TrevorKayongaJoel/PCB-Firmware-for-AWS/NEW PCB FILES/AWS POWER/AWS POWER/AWS POWER.kicad_pcb

## KiCad design NEW PCB FILES/AWS POWER/AWS POWER/AWS POWER.kicad_pcb (2026-09-30)

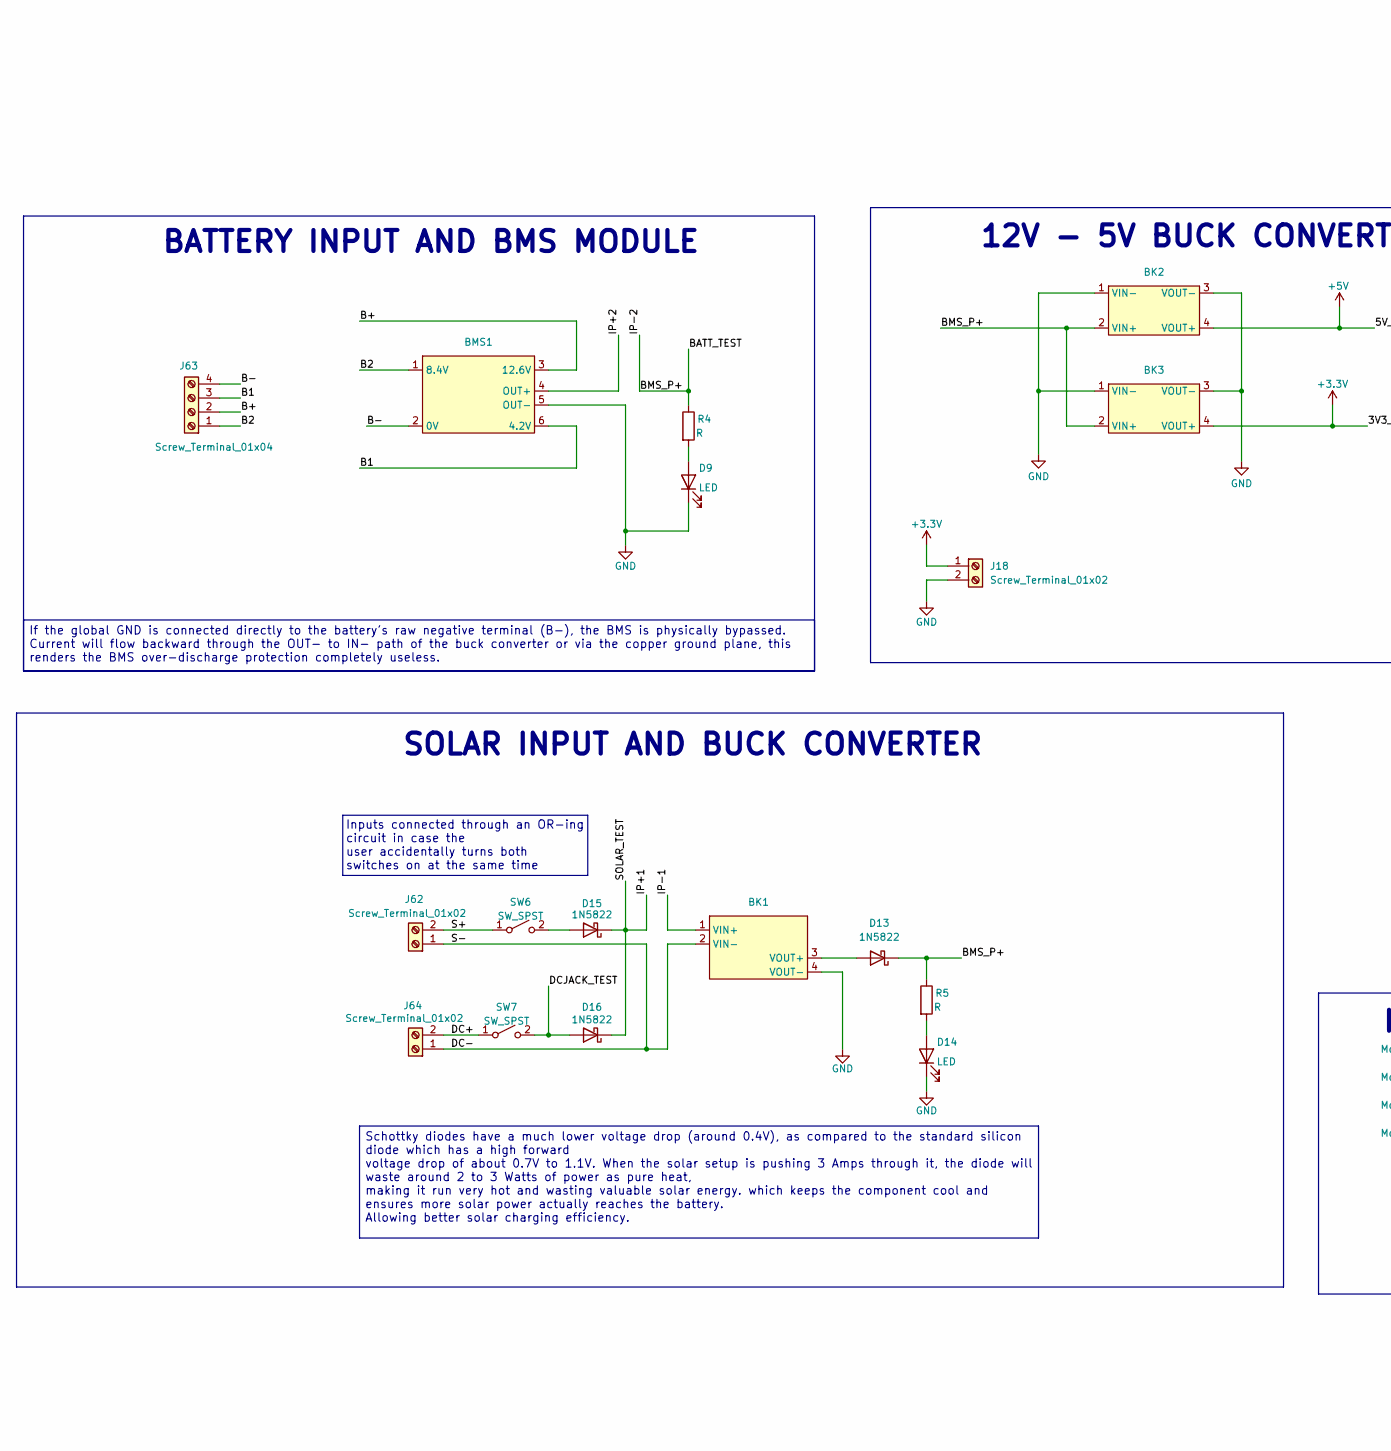
[picture p1: schematic AWS POWER.kicad_sch, part in row 1, column 1]

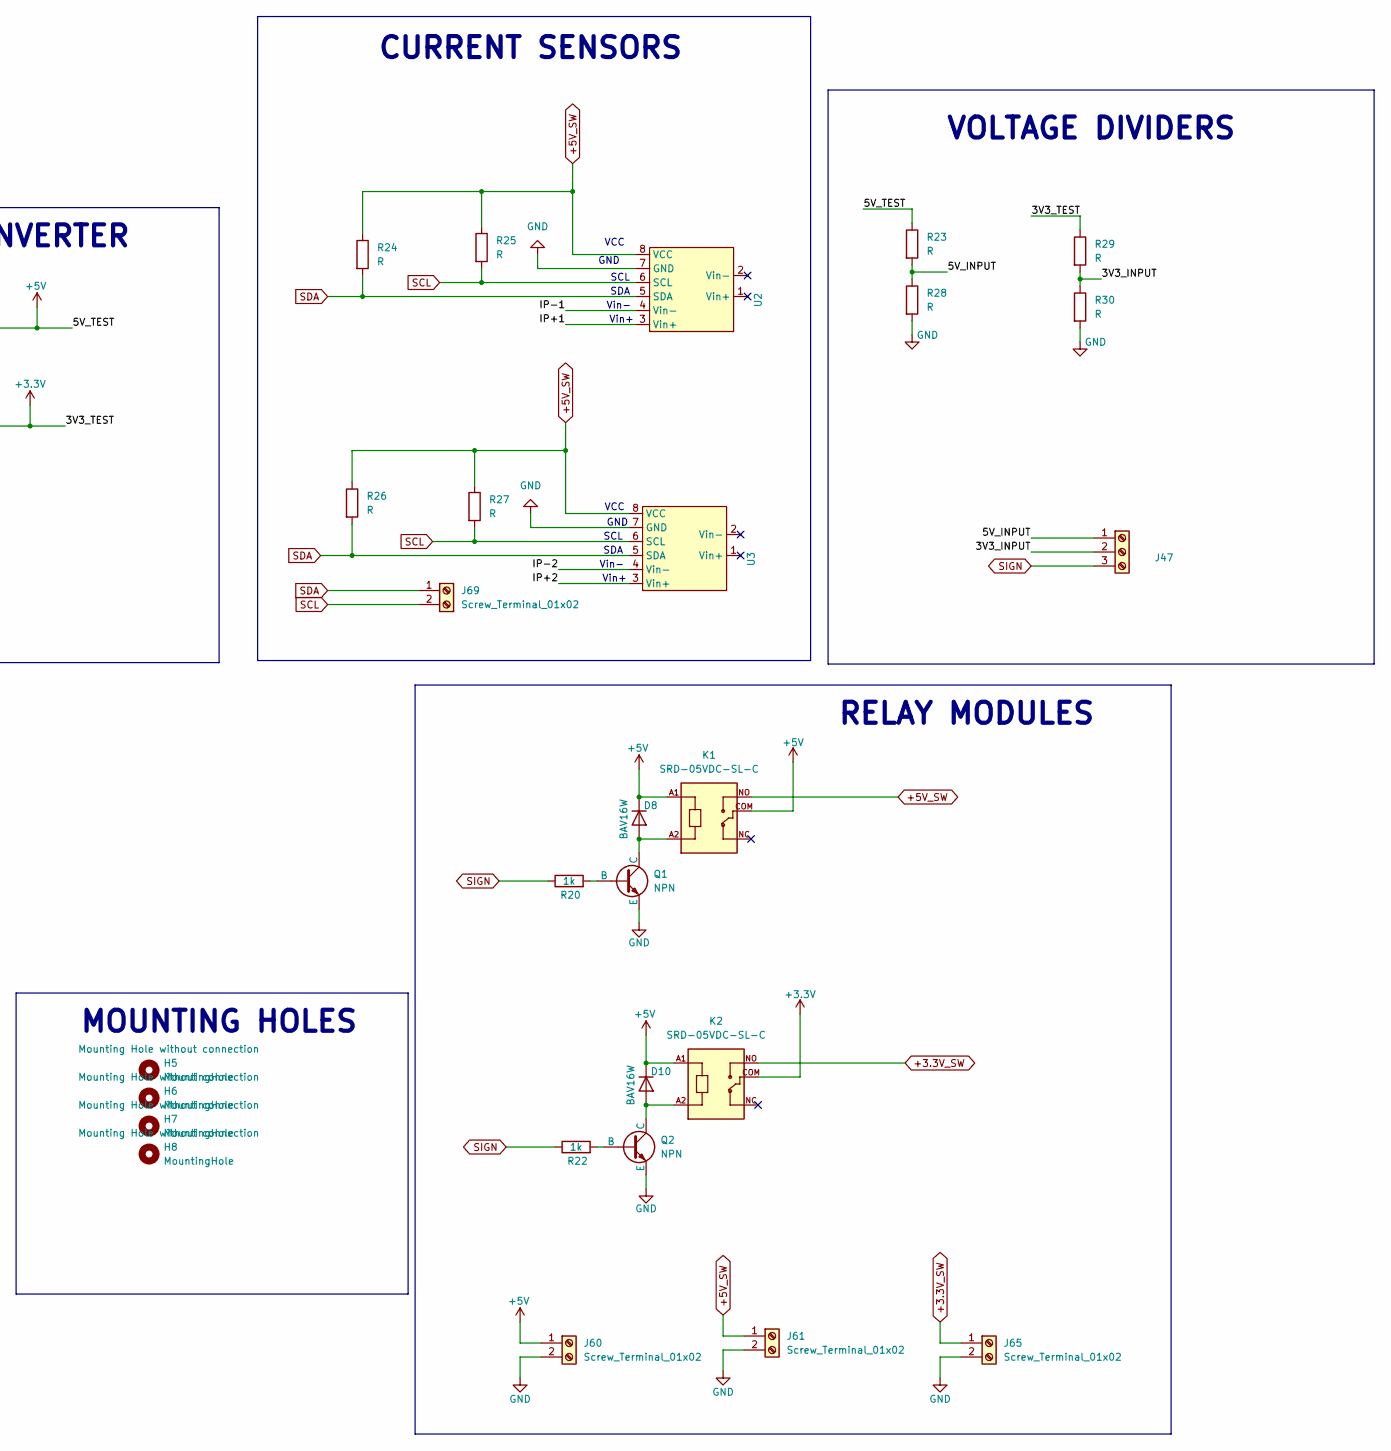
[picture p2: schematic AWS POWER.kicad_sch, part in row 1, column 2]

Parts:
BK1: cn4015-2_module
BK2, BK3: MP1584 MODULE
BMS1: 3S 40A BMS
D8, D10: BAV16W; D_DO-201AD_P15.24mm_Horizontal; LCSC C459527
D9, D14: LED; LED_D3.0mm
D13, D15, D16: 1N5822; D_DO-201AD_P15.24mm_Horizontal
H5, H6, H7, H8: MountingHole; MountingHole_3.2mm_M3_DIN965_Pad_TopOnly
J18, J60, J61, J62, J64, J65, J69: Screw_Terminal_01x02; TerminalBlock_MetzConnect_Type055_RT01502HDWU_1x02_P5.00mm_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
J47: Screw_Terminal_01x03; TerminalBlock_MaiXu_MX126-5.0-03P_1x03_P5.00mm
J63: Screw_Terminal_01x04; TerminalBlock_MetzConnect_Type055_RT01504HDWU_1x04_P5.00mm_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
K1, K2: SRD-05VDC-SL-C; RELAY_SRD-05VDC-SL-C; LCSC C35449
Q1, Q2: NPN; TO-92; LCSC C52801
R4, R5, R23, R24, R25, R26, R27, R28, R29, R30: R; R_Axial_DIN0207_L6.3mm_D2.5mm_P7.62mm_Horizontal
R20, R22: 1k; R_Axial_DIN0207_L6.3mm_D2.5mm_P7.62mm_Horizontal; LCSC C22548
SW6, SW7: SW_SPST; SW_DIP_SPSTx01_Slide_9.78x4.72mm_W7.62mm_P2.54mm
U2, U3: INA219 MODULE

Connections:
+3.3V: BK3.4 (VOUT+), J18.1, K2.COM, R29.1
+3.3V_SW: J65.1, K2.NO
+5V: BK2.4 (VOUT+), D8.1 (K), D10.1 (K), J60.1, K1.A1, K1.COM, K2.A1, R23.1
+5V_SW: J61.1, K1.NO, R24.1, R25.1, R26.1, R27.1, U2.8 (VCC), U3.8 (VCC)
/3V3_INPUT: J47.2, R29.2, R30.1
/5V_INPUT: J47.1, R23.2, R28.1
/B1: BMS1.6 (4.2V), J63.3
/B2: BMS1.1 (8.4V), J63.1
/B+: BMS1.3 (12.6V), J63.2
/B-: BMS1.2 (0V), J63.4
/BATT_TEST: BK2.2 (VIN+), BK3.2 (VIN+), D13.1 (K), R4.1, R5.1, U3.4 (Vin-)
/DC+: J64.2, SW7.1 (A)
/DC-: BK1.2 (VIN-), J62.1, J64.1
/DCJACK_TEST: D16.2 (A), SW7.2 (B)
/IP+1: D15.1 (K), D16.1 (K), U2.3 (Vin+)
/IP+2: BMS1.4 (OUT+), U3.3 (Vin+)
/IP-1: BK1.1 (VIN+), U2.4 (Vin-)
/S+: J62.2, SW6.1 (A)
GND: BK1.4 (VOUT-), BK2.1 (VIN-), BK2.3 (VOUT-), BK3.1 (VIN-), BK3.3 (VOUT-), BMS1.5 (OUT-), D9.1 (K), D14.1 (K), J18.2, J60.2, J61.2, J65.2, Q1.3 (E), Q2.3 (E), R28.2, R30.2, U2.7 (GND), U3.7 (GND)
unnamed: BK1.3 (VOUT+), D13.2 (A)
unnamed: D8.2 (A), K1.A2, Q1.1 (C)
unnamed: D9.2 (A), R4.2
unnamed: D10.2 (A), K2.A2, Q2.1 (C)
unnamed: D14.2 (A), R5.2
unnamed: D15.2 (A), SW6.2 (B)
unnamed: Q1.2 (B), R20.2
unnamed: Q2.2 (B), R22.2
SCL: J69.2, R25.2, R27.2, U2.6 (SCL), U3.6 (SCL)
SDA: J69.1, R24.2, R26.2, U2.5 (SDA), U3.5 (SDA)
SIGN: J47.3, R20.1, R22.1

Notes on the sheet:
SCL
CURRENT SENSORS
Inputs connected through an OR-ing circuit in case the user accidentally turns both switches on at the same time
MOUNTING HOLES
BATTERY INPUT AND BMS MODULE
VOLTAGE DIVIDERS
GND
SOLAR INPUT AND BUCK CONVERTER
SDA
VCC
Vin-
Vin+
RELAY MODULES
12V - 5V BUCK CONVERTER
Schottky diodes have a much lower voltage drop (around 0.4V), as compared to the standard silicon diode which has a high forward voltage drop of about 0.7V to 1.1V. When the solar setup is pushing 3 Amps through it, the diode will waste around 2 to 3 Watts of power as pure heat, making it run very 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
If the global GND is connected directly to the battery's raw negative terminal (B-), the BMS is physically bypassed. Current will flow backward through the OUT- to IN- path of the buck converter or via the copper ground plane, this renders the BMS over-discharge protection completely useless.

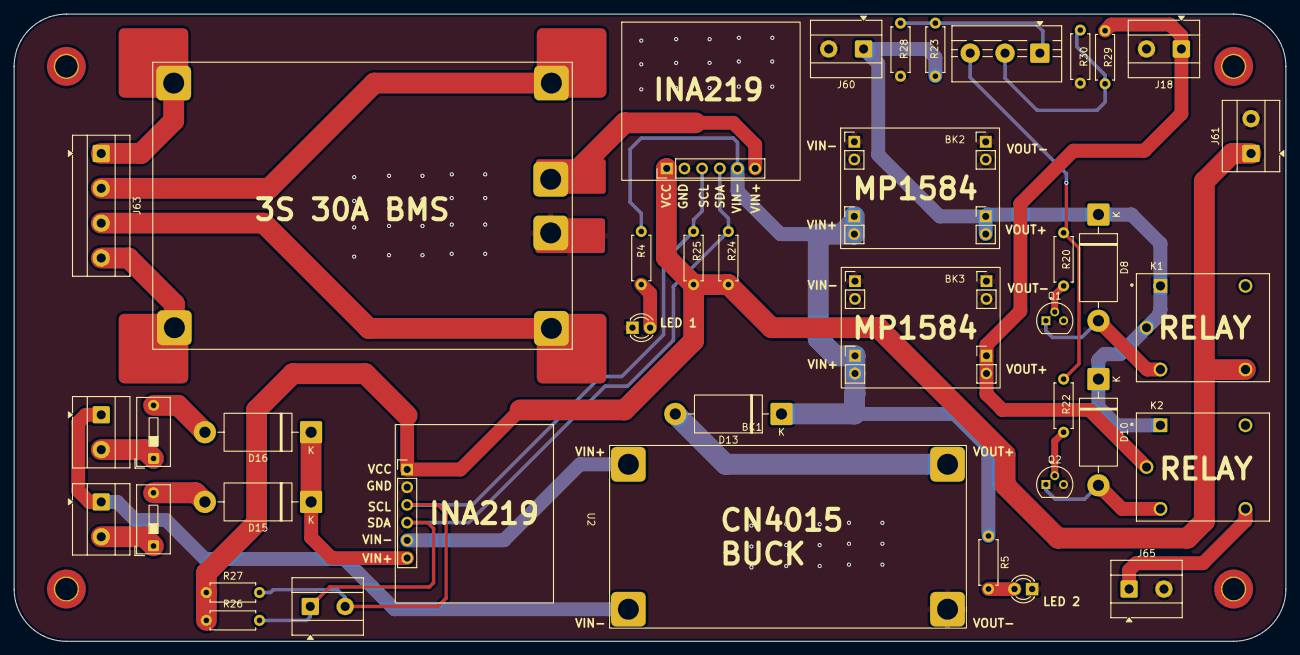
[picture p3: board AWS POWER.kicad_pcb from above]

Board: 2 copper layers, 182.5 x 90.0 mm, 44 parts (0 on the bottom side), 30 nets.

Other parts of the board:
H8#2: MountingHole; MountingHole_3.2mm_M3_DIN965_Pad_TopOnly
