TrevorKayongaJoel/PCB-Firmware-for-AWS/NEW PCB FILES/AWS GATEWAY/AWS GATEWAY.kicad_pcb

## KiCad design NEW PCB FILES/AWS GATEWAY/AWS GATEWAY.kicad_pcb (2026-09-30)

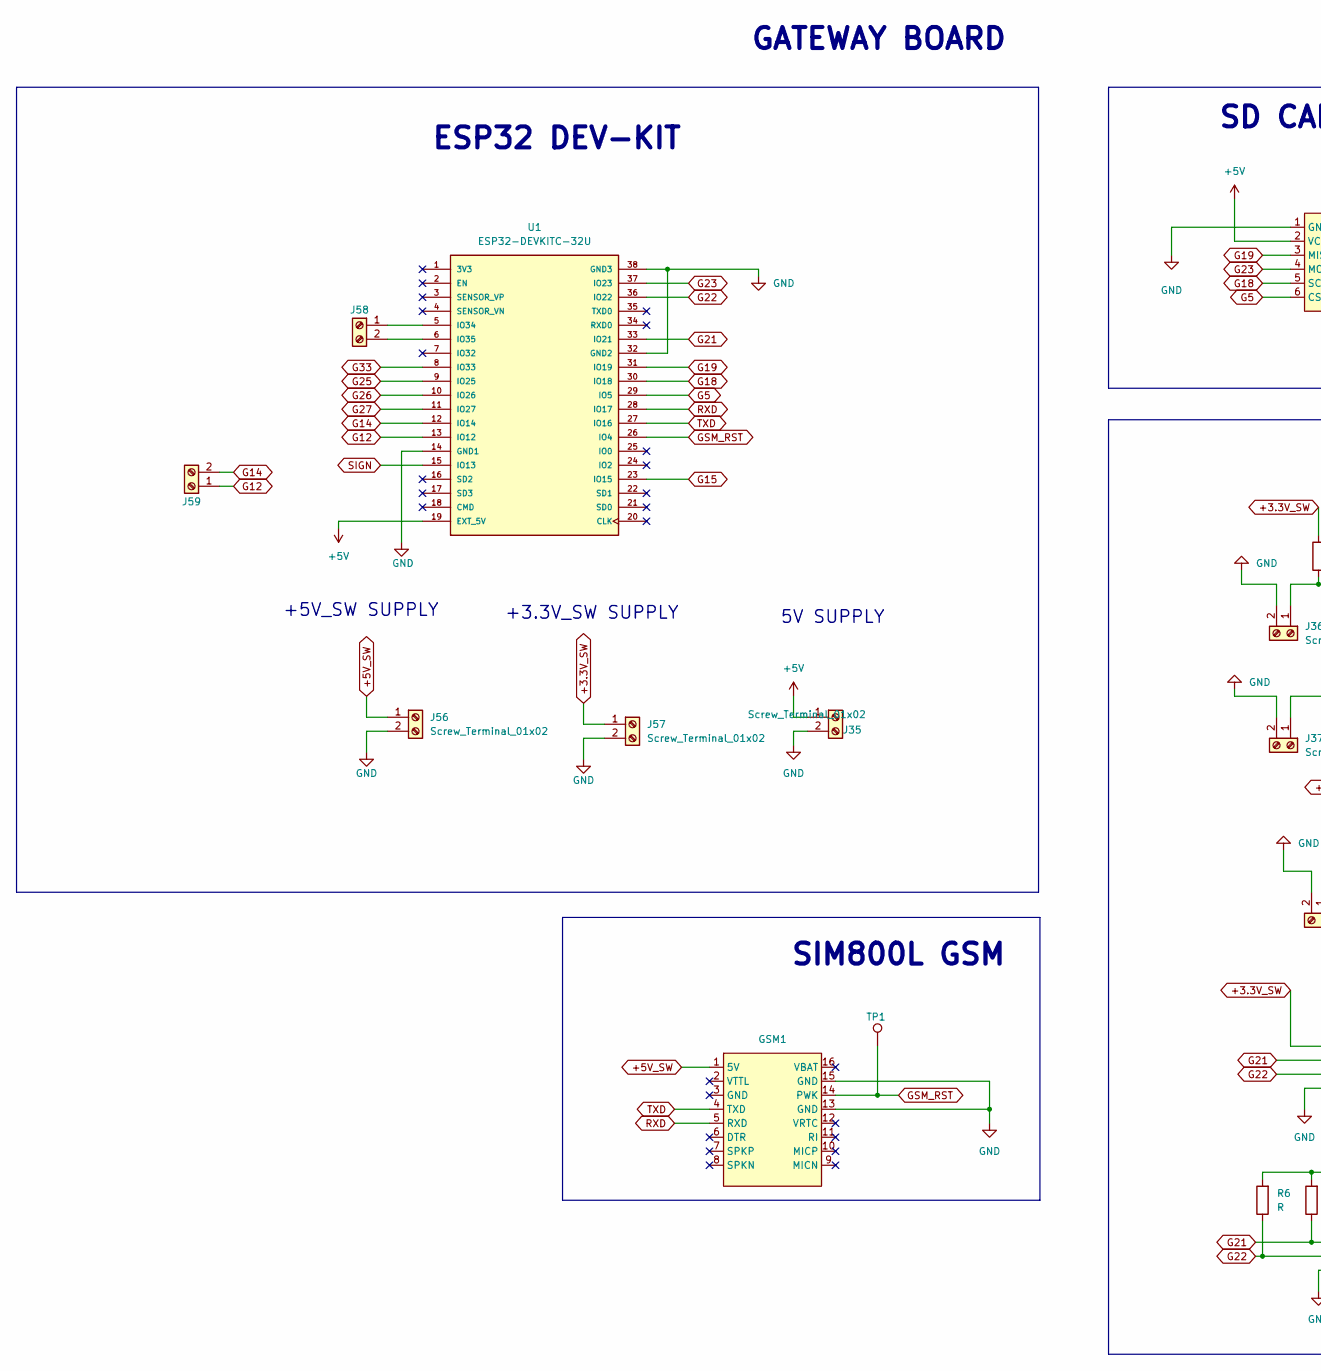
[picture p4: schematic AWS GATEWAY.kicad_sch, part in row 1, column 1]

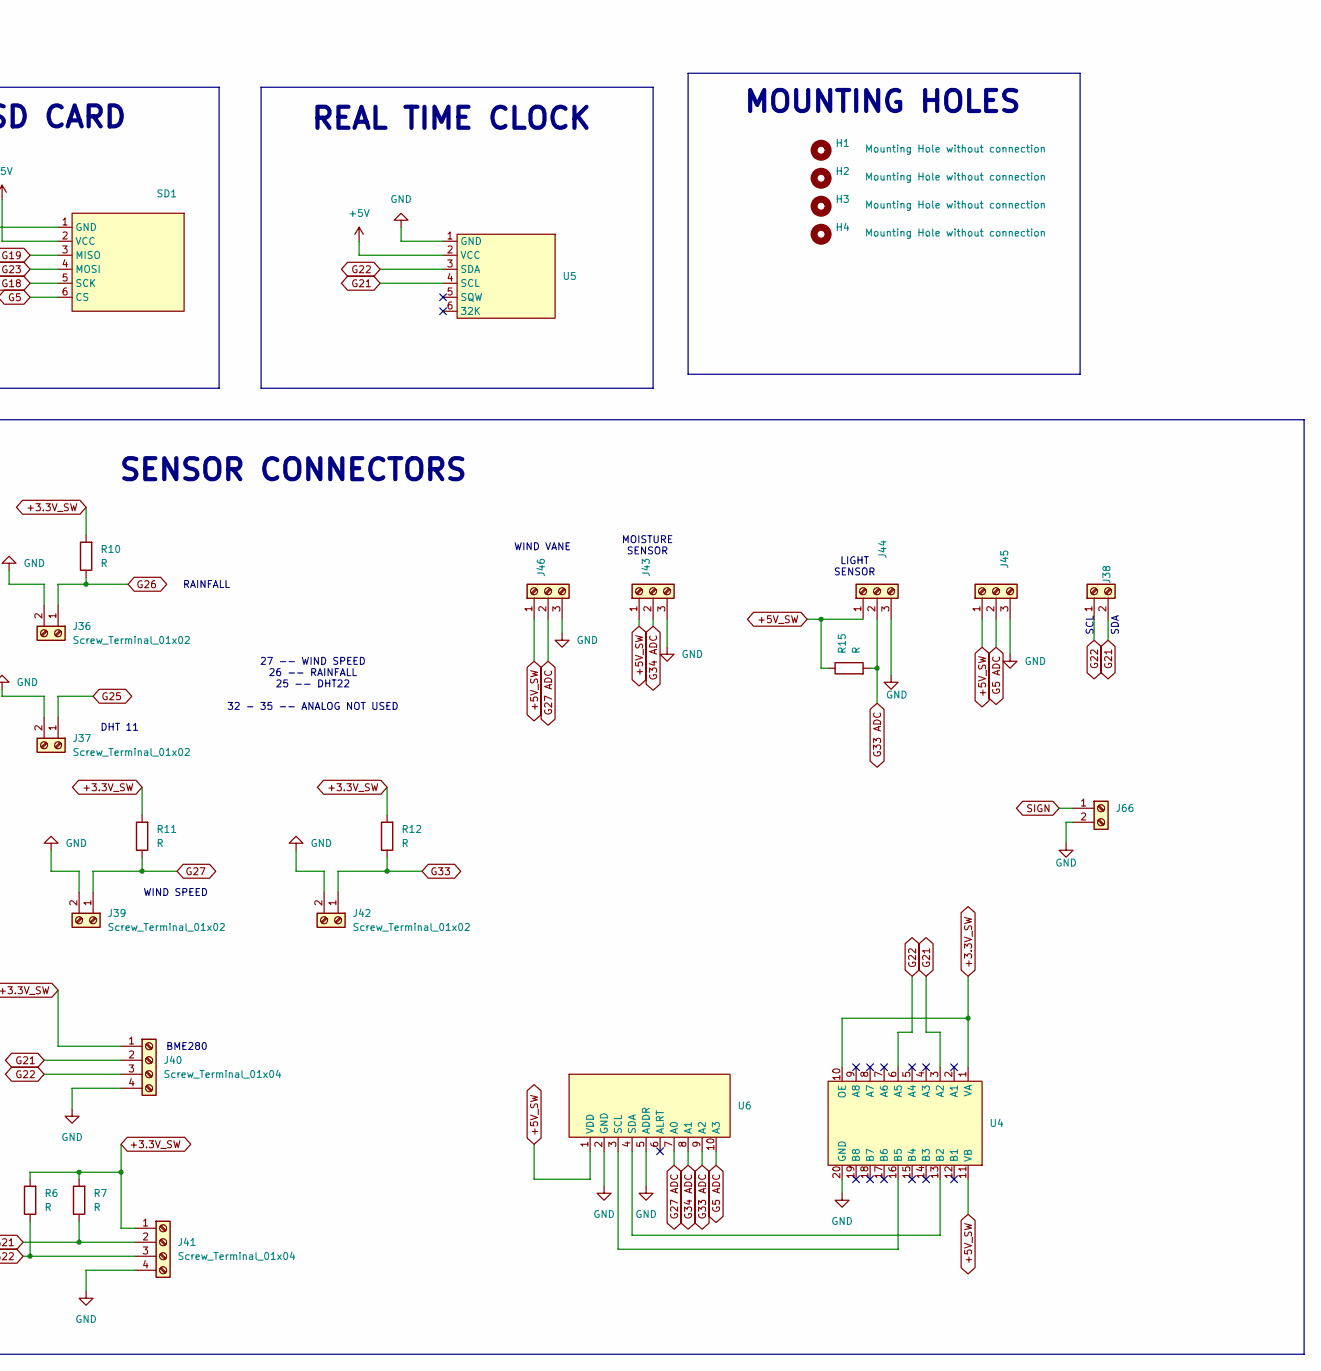
[picture p5: schematic AWS GATEWAY.kicad_sch, part in row 1, column 2]

Parts:
GSM1: GSM MODULE
H1, H2, H3, H4: MountingHole; MountingHole_3.2mm_M3_DIN965_Pad_TopOnly
J35, J36, J37, J38, J39, J42, J56, J57, J58, J59, J66: Screw_Terminal_01x02; TerminalBlock_MaiXu_MX126-5.0-02P_1x02_P5.00mm
J40, J41: Screw_Terminal_01x04; TerminalBlock_MaiXu_MX126-5.0-04P_1x04_P5.00mm
J43, J44, J45, J46: Screw_Terminal_01x03; TerminalBlock_MaiXu_MX126-5.0-03P_1x03_P5.00mm
R6, R7, R10, R11, R12, R15: R; R_Axial_DIN0204_L3.6mm_D1.6mm_P7.62mm_Horizontal
SD1: SD CARD MODULE
TP1: TestPoint; TestPoint_Pad_D3.0mm
U1: ESP32-DEVKITC-32U; MODULE_ESP32-DEVKITC-32U; PARTREV V4
U4: logic level shifter
U5: RTC MODULE
U6: ADS115 MODULE

Connections:
+3.3V_SW: J40.1, J41.1, J57.1, R6.2, R7.2, R10.2, R11.2, R12.2, U4.1 (VA), U4.10 (OE)
+5V: J35.1, SD1.2 (VCC), U1.19 (EXT_5V), U5.2 (VCC)
+5V_SW: GSM1.1 (5V), J43.1, J44.1, J45.1, J46.1, J56.1, R15.1, U4.11 (VB), U6.1 (VDD)
G5: SD1.6 (CS), U1.29 (IO5)
G5 ADC: J45.2, U6.10 (A3)
G12: J59.1, U1.13 (IO12)
G14: J59.2, U1.12 (IO14)
G15: U1.23 (IO15)
G18: SD1.5 (SCK), U1.30 (IO18)
G19: SD1.3 (MISO), U1.31 (IO19)
G21: J38.2, J40.2, J41.2, R7.1, U1.33 (IO21), U4.3 (A2), U5.4 (SCL)
G22: J38.1, J40.3, J41.3, R6.1, U1.36 (IO22), U4.6 (A5), U5.3 (SDA)
G23: SD1.4 (MOSI), U1.37 (IO23)
G25: J37.1, U1.9 (IO25)
G26: J36.1, R10.1, U1.10 (IO26)
G27: J39.1, R11.1, U1.11 (IO27)
G27 ADC: J46.2, U6.7 (A0)
G33: J42.1, R12.1, U1.8 (IO33)
G33 ADC: J44.2, R15.2, U6.9 (A2)
G34 ADC: J43.2, U6.8 (A1)
GND: GSM1.13 (GND), GSM1.15 (GND), J35.2, J36.2, J37.2, J39.2, J40.4, J41.4, J42.2, J43.3, J44.3, J45.3, J46.3, J56.2, J57.2, J66.2, SD1.1 (GND), U1.14 (GND1), U1.32 (GND2), U1.38 (GND3), U4.20 (GND), U5.1 (GND), U6.2 (GND), U6.5 (ADDR)
GSM_RST: GSM1.14 (PWK), TP1.1 (1_1), U1.26 (IO4)
unnamed: J58.1, U1.5 (IO34)
unnamed: J58.2, U1.6 (IO35)
unnamed: U4.13 (B2), U6.4 (SDA)
unnamed: U4.16 (B5), U6.3 (SCL)
RXD: GSM1.5 (RXD), U1.28 (IO17)
SIGN: J66.1, U1.15 (IO13)
TXD: GSM1.4 (TXD), U1.27 (IO16)

Notes on the sheet:
GATEWAY BOARD
SENSOR CONNECTORS
MOUNTING HOLES
+5V_SW SUPPLY
SDA
MOISTURE SENSOR
SD CARD
RAINFALL
WIND VANE
LIGHT SENSOR
WIND SPEED
SCL
BME280
27 -- WIND SPEED 26 -- RAINFALL 25 -- DHT22 32 - 35 -- ANALOG NOT USED
DHT 11
REAL TIME CLOCK
ESP32 DEV-KIT
+3.3V_SW SUPPLY
5V SUPPLY
SIM800L GSM

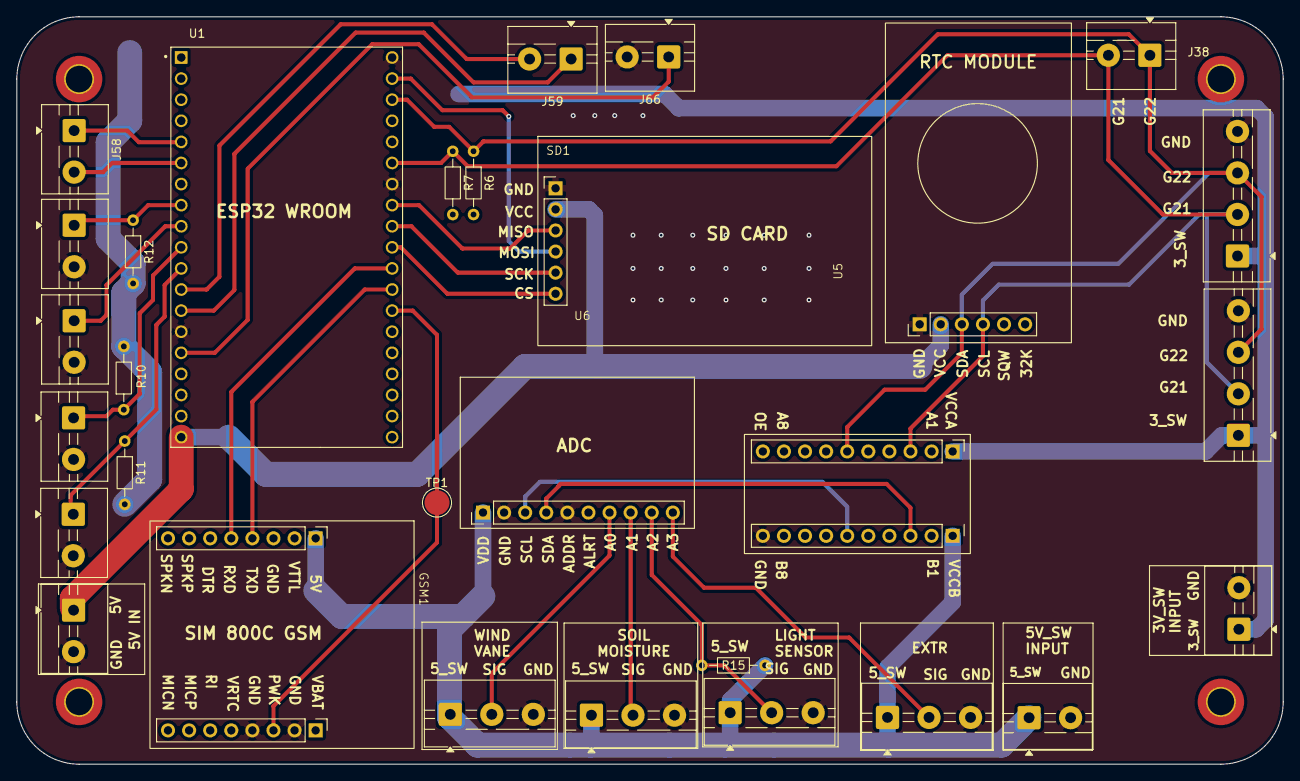
[picture p6: board AWS GATEWAY.kicad_pcb from above]

Board: 2 copper layers, 152.5 x 90.0 mm, 34 parts (0 on the bottom side), 28 nets.
